centaurusgod/lpf_accelerator_riscv/audios/love_is_a_burning_thing.png

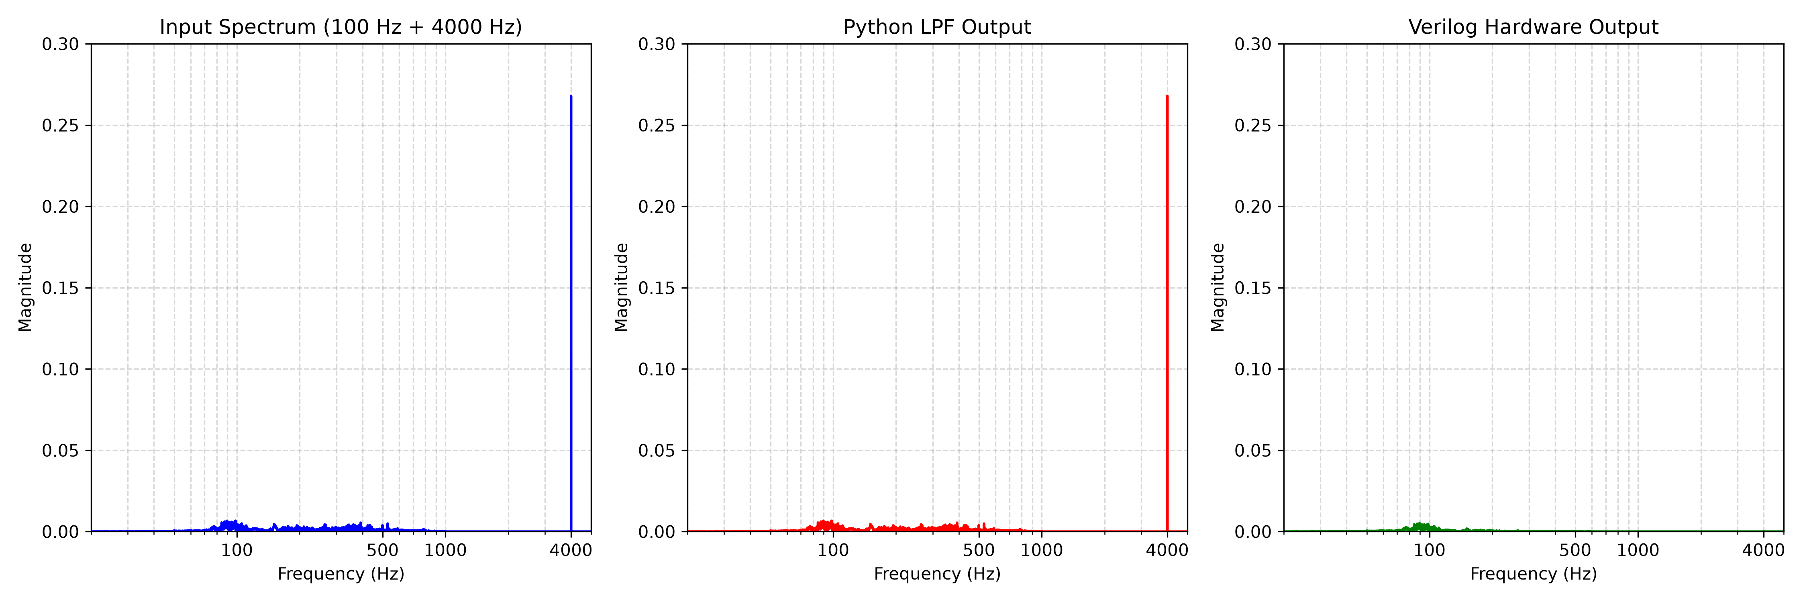
audios/love_is_a_burning_thing.png
