centaurusgod/lpf_accelerator_riscv/media/single_cycle_processor.png

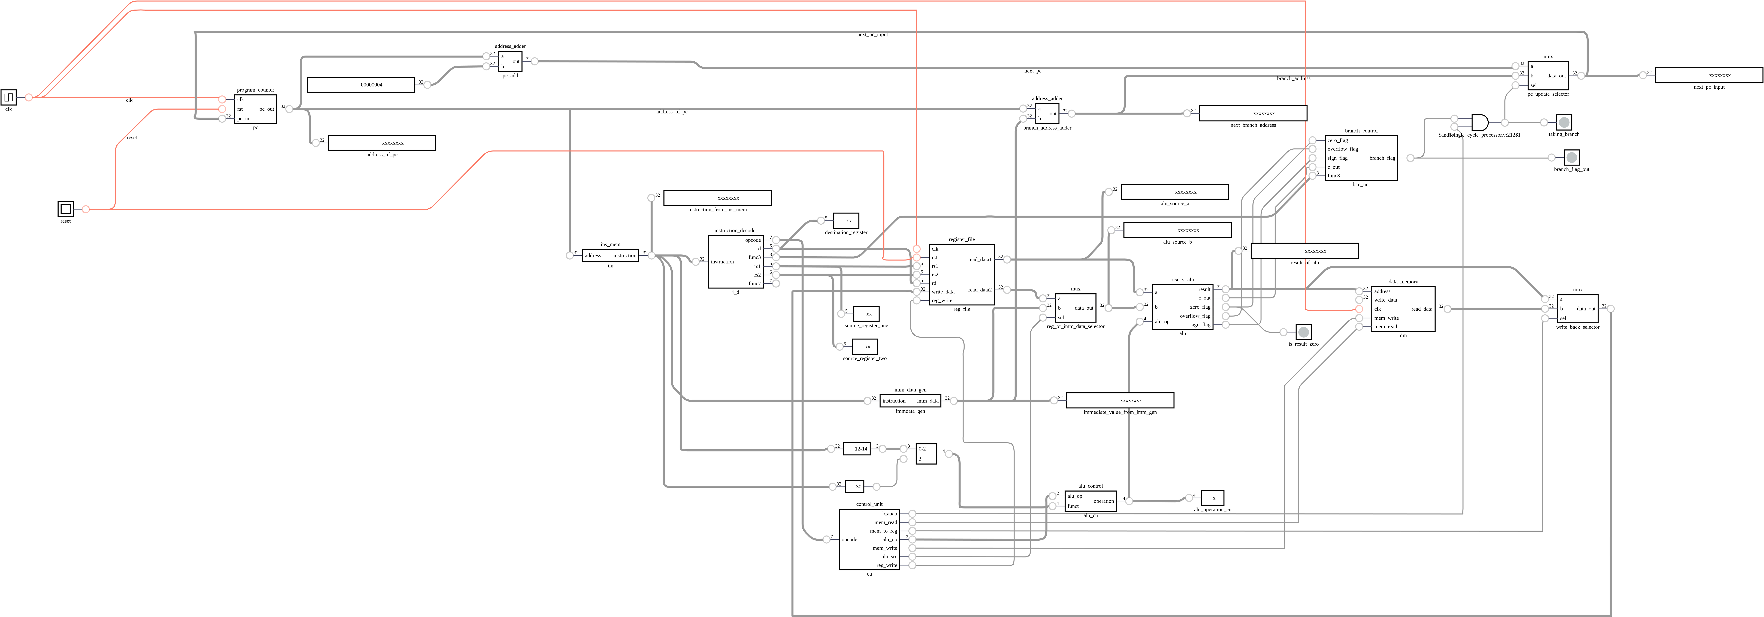
media/single_cycle_processor.png
