centaurusgod/lpf_accelerator_riscv/media/yosys_lpf.png

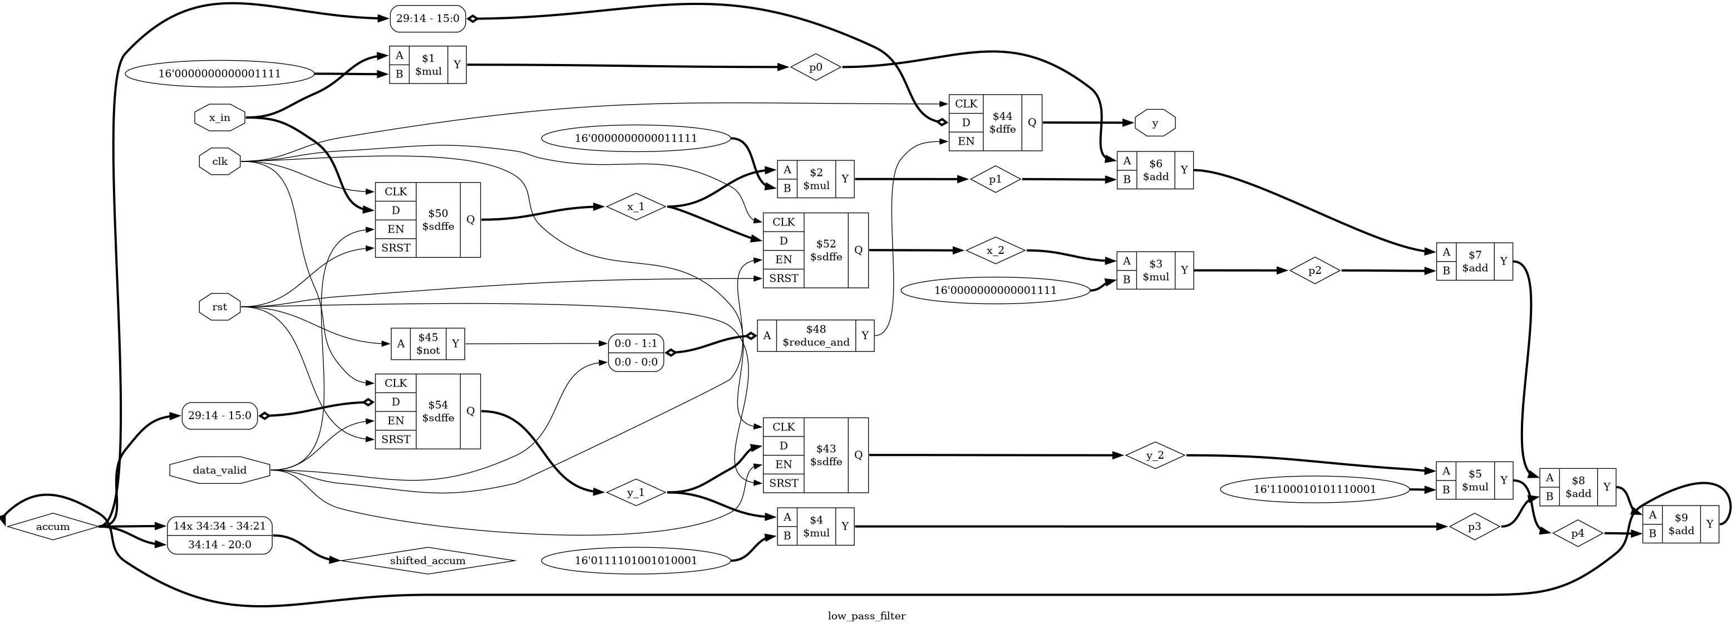
media/yosys_lpf.png
