centaurusgod/lpf_accelerator_riscv/media/processor_v_accelerator_performance_comparison.png

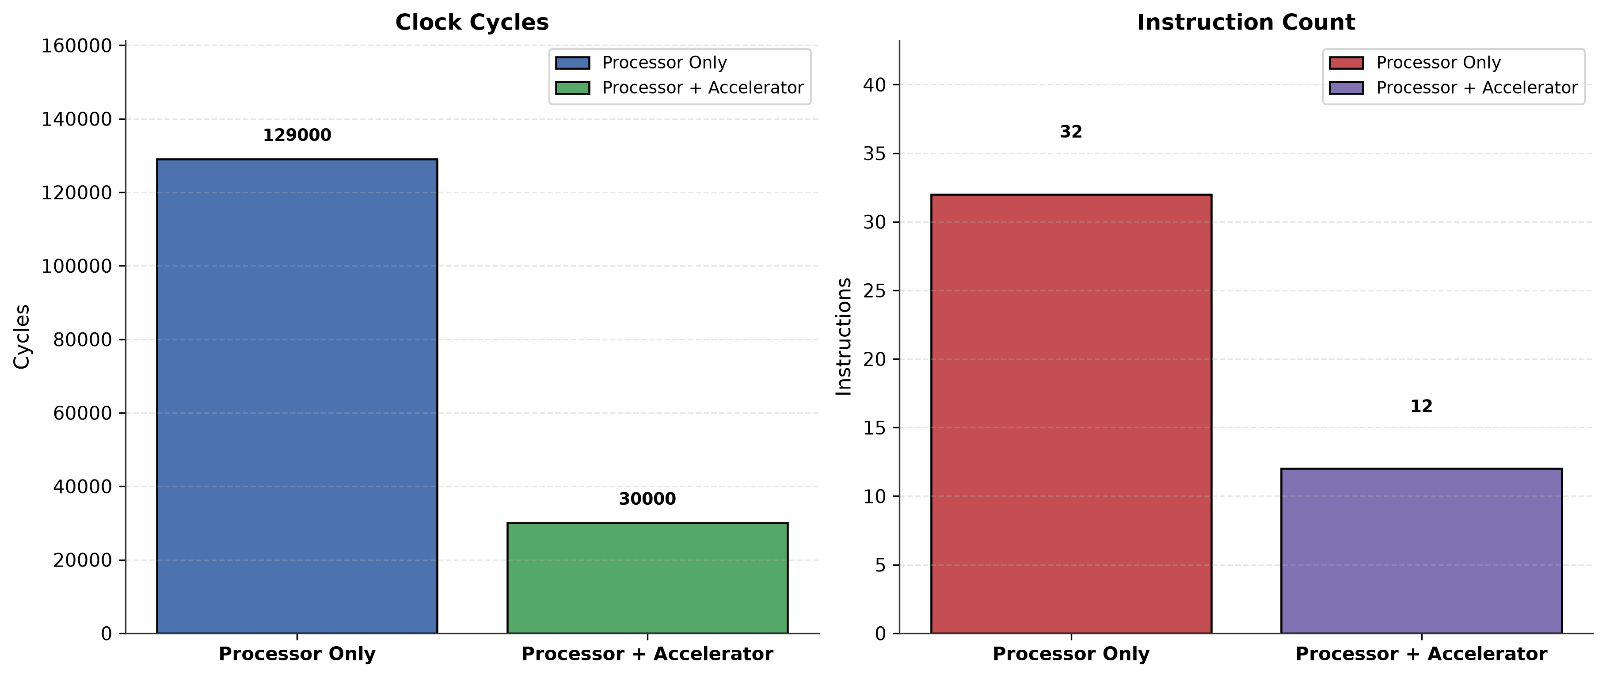
media/processor_v_accelerator_performance_comparison.png
