centaurusgod/lpf_accelerator_riscv/verilog_modules/program_counter.v

module program_counter (
    input clk,
    input rst,
    input [31:0] pc_in,
    output reg [31:0] pc_out
);
    always @(posedge clk or posedge rst) begin
        if (rst) begin
            pc_out <= 32'b0;
        end else begin
            pc_out <= pc_in;
        end
    end

endmodule
