centaurusgod/lpf_accelerator_riscv/(commit log)

2026-03-29 refactor: add branch control unit and minor fixes
    [branch_control.v, control_unit.v, imm_data_gen.v, risc_v_alu.v, single_cycle_processor.v, tb_single_cycle_processor.v]
2026-09-02 fix: alu_op for immediate type instructions
    [control_unit.v]
2026-09-05 Add low pass filter and mmio module
2026-09-12 refactor: remove unused wire
